DIY14Pflanze/diyPflanze/linuxStation/README.txt

Hier kommt der Code für die Linuxstation (Banapie) rein.
