DIY14Pflanze/diyPflanze/doku/doku2.tex

\documentclass[]{IEEEtran}
\usepackage[utf8]{inputenc}		%UTF8 input file
\usepackage[T1]{fontenc}		
\usepackage[ngerman]{babel}
\usepackage{amsmath, amssymb}
\usepackage{eurosym}
\usepackage{hyperref}
%Für Fußzeilten
%\usepackage{stfloats}
%Bilder
\usepackage{graphicx}
\usepackage{epstopdf}
%Zeilenabstände
\usepackage{setspace}

%Für Quellcode
\usepackage{listings}

\title{Pflanzengießanlage}
%\subtitle{DIY14Pflanze}
\date{\today}
\author{ Stefan Schubäck, \and Matthias Nagl,\and Christoph Hofbauer, \and Dmitrii Cetvericov, \and Markus Fischer-Has,}

%\renewcommand{\iedlistdecl}{\settowidth{\labelwidth}{Hello}}

\begin{document}

	\maketitle
%	\tableofcontents

\begin{abstract}
Auch unter den Studenten gibt es den einen oder anderen mit einem grünen Daumen, der seine Wohnung durch ein paar Pflanzen aufgewertet hat. 
Wenn nicht das ständige Gießen wäre. 
Vor jedem längeren Urlaub stellt sich die Frage, was machen mit den Pflanzen? 
Den Nachbarn fragen und hoffen er ist da und verlässlich? 
Die Pflanzen \glqq absaufen\grqq \ lassen und hoffen, dass sie sich das Wasser einteilen? 
Beides keine zufriedenstellende Lösung. Wieso lässt man die Pflanze sich nicht selbst gießen?
Aus diesen Überlegungen ist die Idee entstanden eine Pflanze mit Sensoren auszustatten und so deren Zustand zu überwachen und über diesen zu informieren.
Im Folgenden wird der Aufbau zweier Lösungen vorgestellt. 

Der erste Ansatz basiert auf dem Arduino"~System, welches einen einfachen Einstieg in Umgang mit Mikrocontroller ermöglicht. 
Der zweite Ansatz basiert auf ähnlicher Hardware, jedoch ohne die Verwendung der Arduino"~Software. 
Dadurch wird die Verwendung von Sleep"~Modi und Interrupts möglich was eine Low"~Energy Variante des Gießsystems ermöglicht.  

\end{abstract}

\section{Eingrenzung}
Es lassen sich viele Faktoren finden, die einen Einfluss auf das Wohlbefinden eine Pflanze haben. 
Hierunter fallen die Bodenfeuchtigkeit im Topf der Pflanze, die durchschnittliche Sonneneinstrahlung, die Luftqualität, der Nährstoffgehalt des Bodens sowie die Temperatur. 
Diese nicht abschließende Aufzählung zeigt, dass eine Eingrenzung der zu untersuchenden Faktoren notwendig ist, um das Projekt in der gegeben Zeit fertigzustellen.
Auch hinsichtlich des Einsatzgebietes gibt eine Vielfalt von unterschiedlichen Möglichkeiten wie z.B. Einpflanzenbetrieb oder Mehrpflanzenbetrieb sowie In"~ oder Outdoor"~Betrieb. 
Im Rahmen des Projekts werden demnach folgende Eingrenzung vorgenommen:

\begin{itemize}
	\item Die Bodenfeuchtigkeit wird abgeleitet aus der Widerstandsänderung einer Messgabel die sich im Erdreich der Pflanze befindet. Die Widerstandsänderung ergibt sich in Abhängigkeit des Wassergehalts bzw. Feuchtigkeitgrades der Erde.
	\item Das System soll für eine alleinstehende Pflanze aufgebaut werden. 
	\item Das Einsatzgebiet wird im Innenraumbereich sein, dadurch fallen Einschränkungen bzgl. der Witterungs"-beständigkeit weg.
	\item Die Stromversorgung wird über ein Netzteil bewerkstelligt. 
	\item Das System soll über eine drahtlose Verbindung einstellbar sein. Diese Einschränkung gilt nur für die \emph{Arduino"~Variante}, da in der \emph{Sparversion} auf Grund energetischer Optimierung auf die Kommunikation verzichtet wird. Hier wird die Einstellung direkt im Code vorgenommen.

\end{itemize}

Weitere Ideen wie z.B. eine autarke, batteriebetriebene Lösung, ein Mehr"~Pflanzenbetrieb oder ein System für den Garten wurden zwar diskutiert, aber wegen dem erhörten Zeitaufwand hinsichtlich weiterer zu lösender Problemstellungen und begrenzten Budgets nicht weiter verfolgt. 
Im folgenden wird die \emph{Arduino"~Variante} ausführlich vorgestellt. 
Die \emph{Sparversion} wird im Anschluss erläutert. Da viele der Funktionen grundsätzlich identisch sind und übernommen werden können, wird darauf verzichtet diese erneut auszuformulieren. 

%section
\input{arduinoVariante.tex}

%section
\input{sparversion.tex}

\input{fazit.tex}

\end{document}
