DIY14Pflanze/diyPflanze/doku/fazit.tex

\section{Weiterentwicklung}

\subsection{Konfigurationstool}
Um die Daten der Gießanlage auslesen und die Konfiguration auf eine Pflanze vornehmen zu können, fehlt noch das PC"~Programm. 
Dieses Programm soll über eine Oberfläche die Einstellungen der Gießanlage(-n) anzeigen und diese auf die jeweilige Pflanze, Boden- und Licht"-Verhältnisse anpassen können.
Es gibt erste Ansätze, die jedoch noch am Anfang ihrer Entwicklung stehen.

\subsection{Kapazitive Bodenfeuchtigkeitsmessung}
Das größte Problem vor dem wir stehen, ist der sich durch Elektrolyse zersetzende Bodenfeuchtigkeitssensor.
Durch das seltenere Messen und das Umpolen lässt sich die Lebensdauer des Sensor deutlich verlängern, aber die Selbstzerstörung nicht aufhalten.
So nimmt die Leitfähigkeit des Sensors mit der Zeit ab und die Messwerte verringern sich über die Zeit.
Außerdem besteht der Sensor aus einer verzinkten Kupferplatine und durch die Korrosion werden Kupferionen frei gesetzt. 
Diese werden von den Pflanzen aufgenommen. Falls es sich um Nutzpflanzen zum Verzehr handelt, gelangen die giftigen Kupferionen in den menschlichen Körper.
Deswegen wurde hier vorgeschlagen einen kapazitiven Sensor zu verwenden. 
Bei einem kapazitiven Sensor berührt kein Metall die Pflanzenerde, so kommt es zu keiner Korrosion.
Dafür muss eine Kapazität gemessen werden, was schaltungstechnisch schwer zu realisieren ist\footnote{\href{http://www.dl8nci.de/lc-meter-001.html}{http://www.dl8nci.de/lc-meter-001.html}}.
