DIY14Pflanze/diyPflanze/gehaeuse/box-20150116_081555_312084.pdf

Cut Width: 0.0000mm
Material Thickness: 3.0000mm
W x D x H: 95.00mm x 65.00mm x 50.00mm
Produced by BoxMaker v2.0.1 on 01/16/2015 at 08:15:55 http://boxmaker.connectionlab.org
