DIY14Pflanze/diyPflanze/microcontroller/src/README.txt

Hier kommt der Code für den Mikrocontroller rein.
