DIY14Pflanze/diyPflanze/doku/bilder/boxFron0.JPG

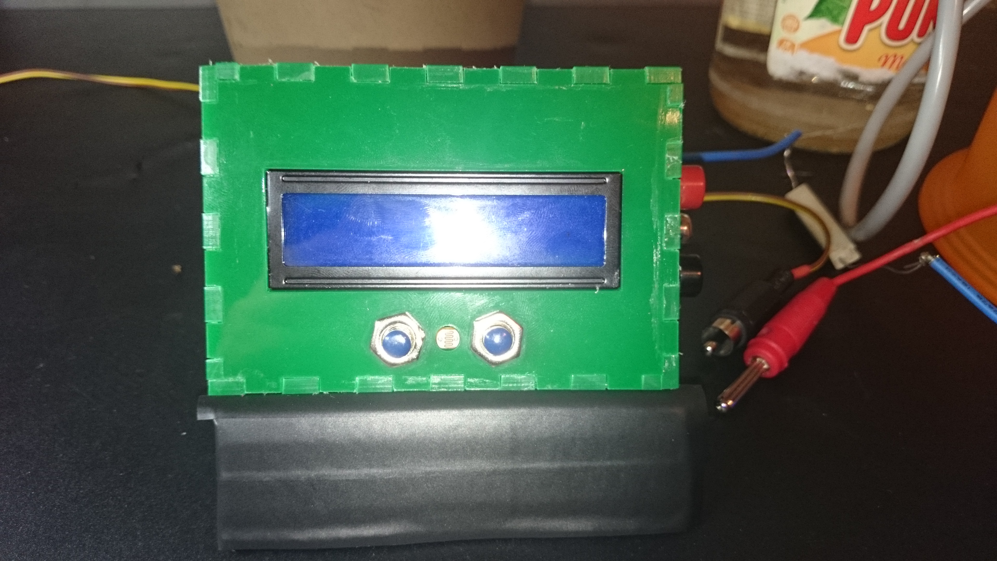
doku/bilder/boxFron0.JPG
