DIY14Pflanze/diyPflanze/doku/bilder/boxFron1.JPG

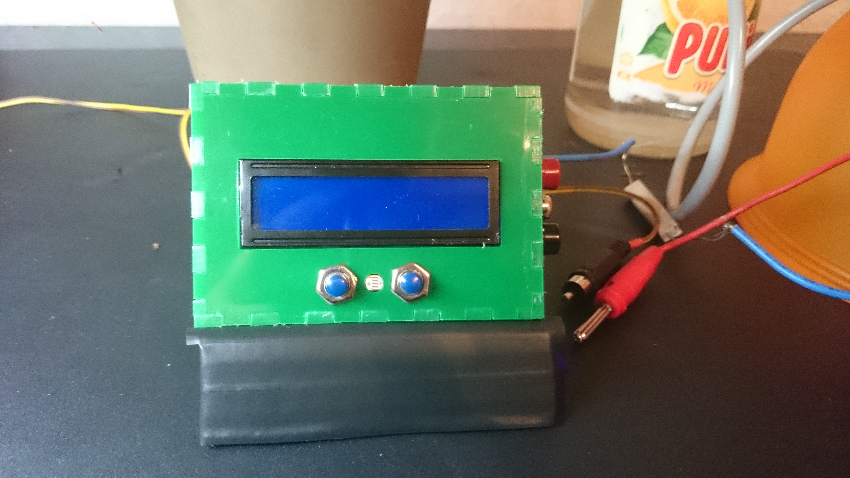
doku/bilder/boxFron1.JPG
