DIY14Pflanze/diyPflanze/doku/bilder/boxInnen0.JPG

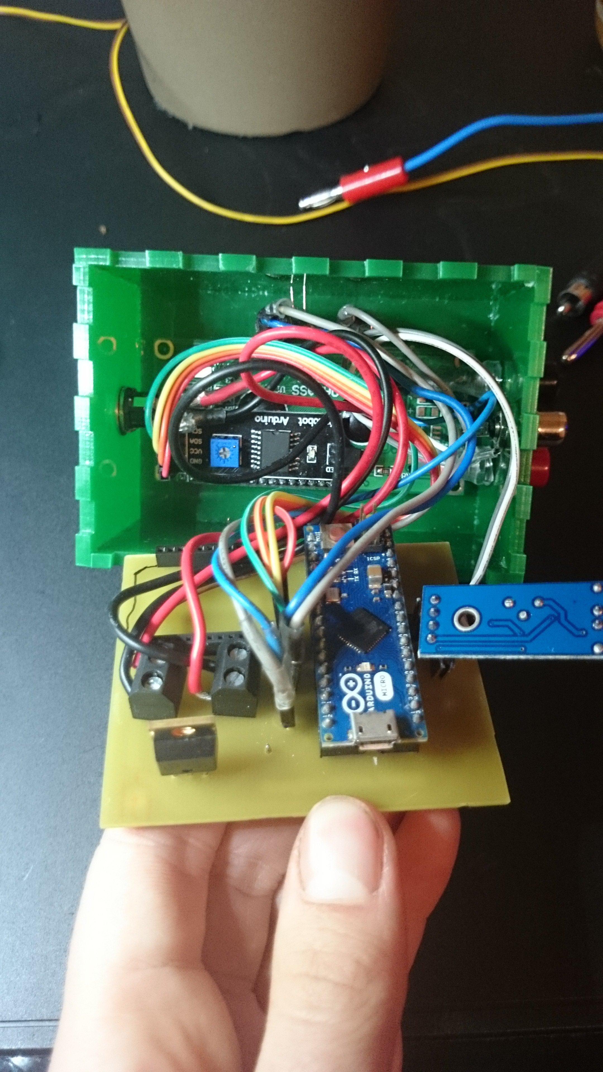
doku/bilder/boxInnen0.JPG
