DIY14Pflanze/diyPflanze/doku/bilder/boxPeripherie0.JPG

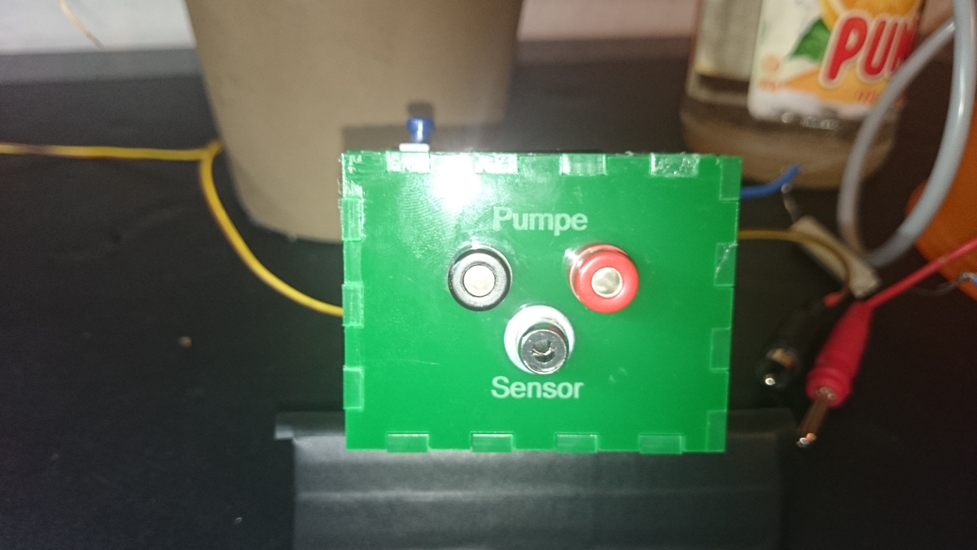
doku/bilder/boxPeripherie0.JPG
