DIY14Pflanze/diyPflanze/doku/bilder/boxPeripherie1.JPG

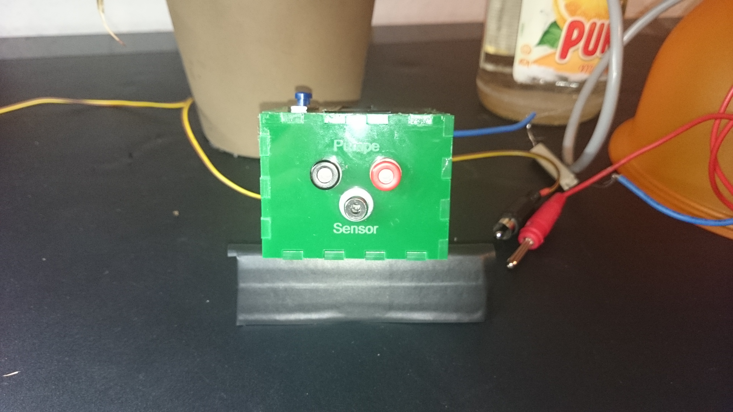
doku/bilder/boxPeripherie1.JPG
