DIY14Pflanze/diyPflanze/doku/bilder/boxStrom0.JPG

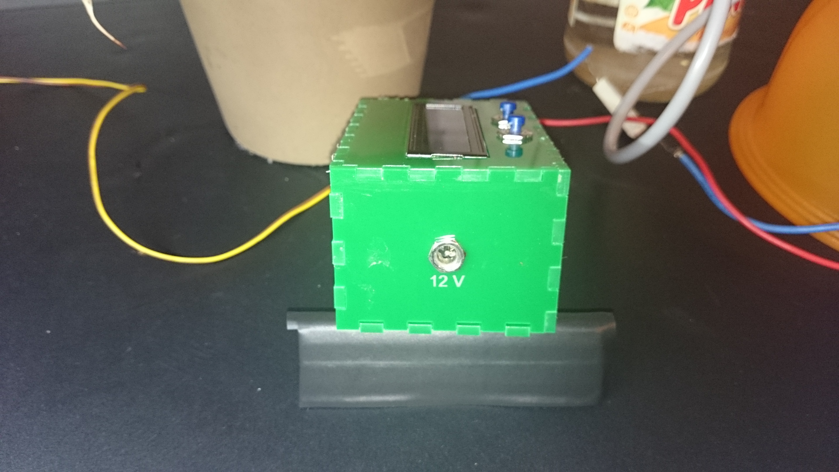
doku/bilder/boxStrom0.JPG
