DIY14Pflanze/diyPflanze/doku/bilder/fechtesensorVergleich0.JPG

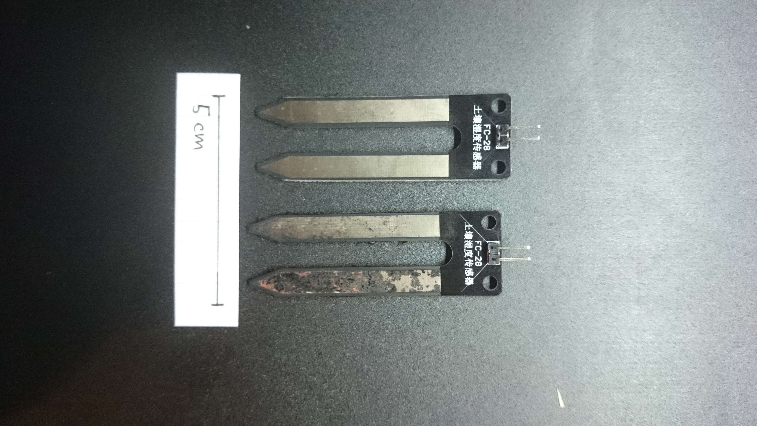
doku/bilder/fechtesensorVergleich0.JPG
