DIY14Pflanze/diyPflanze/doku/bilder/feuchteSensor0.JPG

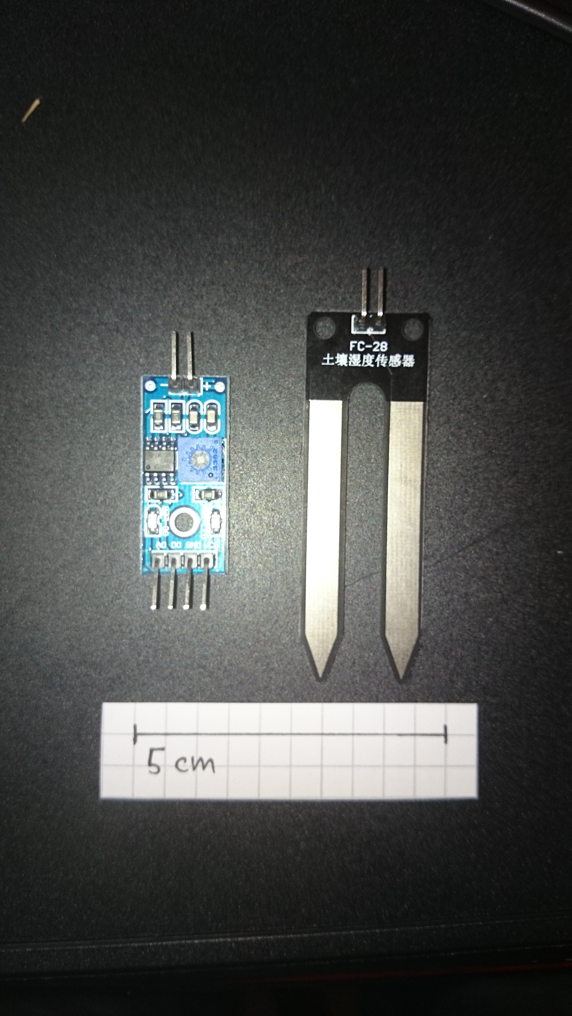
doku/bilder/feuchteSensor0.JPG
