DIY14Pflanze/diyPflanze/doku/bilder/feuchteSensor1.JPG

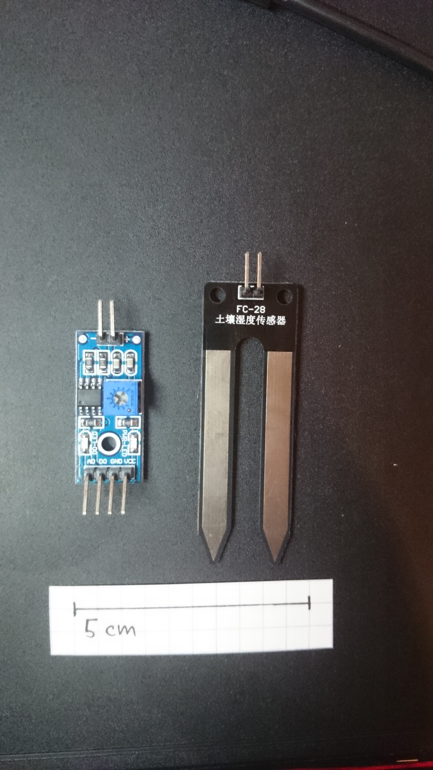
doku/bilder/feuchteSensor1.JPG
