DIY14Pflanze/diyPflanze/doku/bilder/feuchtesensorVergleich1.JPG

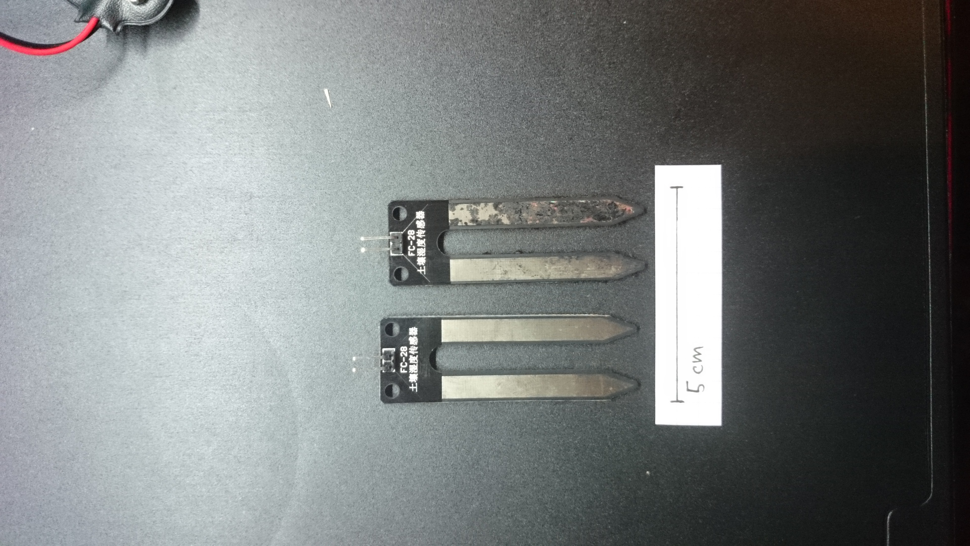
doku/bilder/feuchtesensorVergleich1.JPG
