DIY14Pflanze/diyPflanze/doku/bilder/feuchtesensorVergleich3.JPG

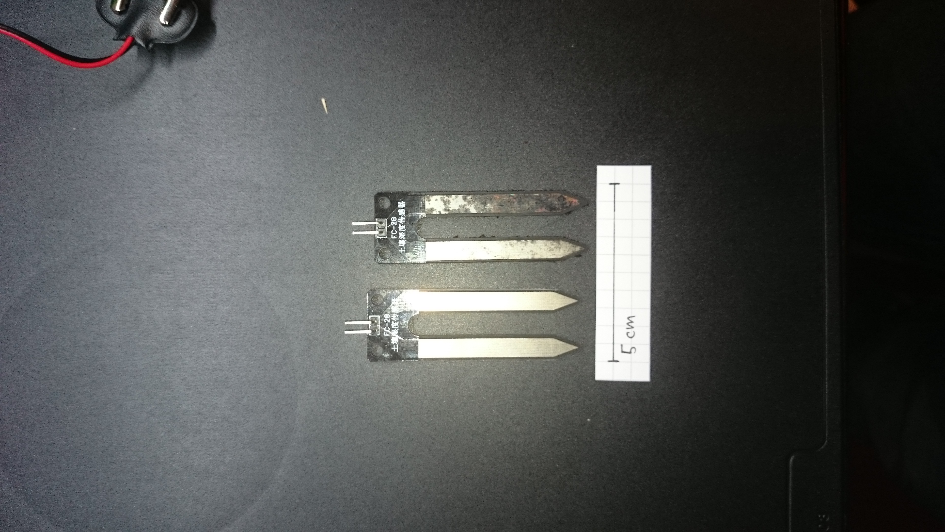
doku/bilder/feuchtesensorVergleich3.JPG
