DIY14Pflanze/diyPflanze/doku/bilder/komplett0.JPG

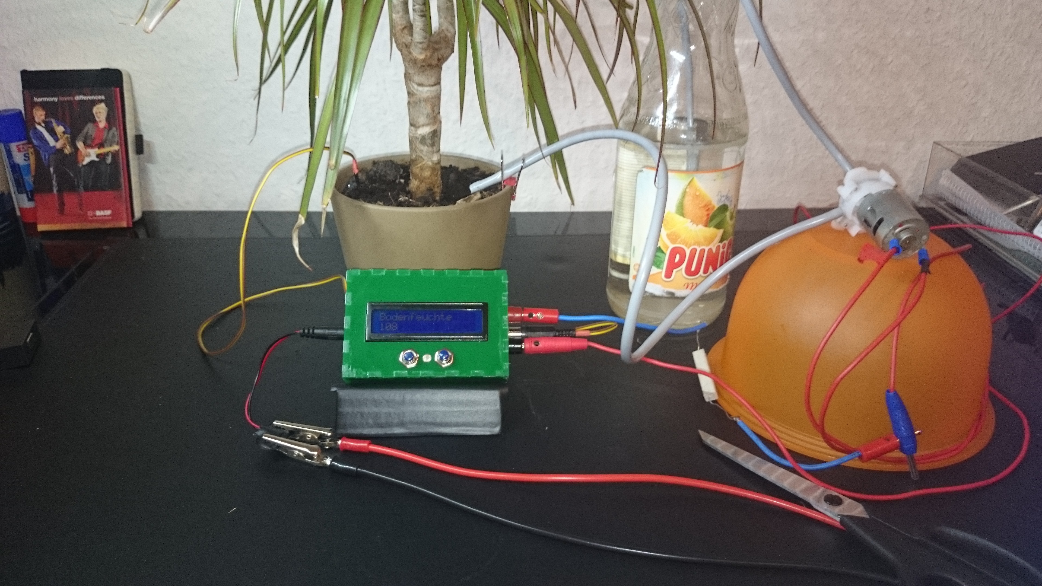
doku/bilder/komplett0.JPG
