DIY14Pflanze/diyPflanze/doku/bilder/komplett0_v1.JPG

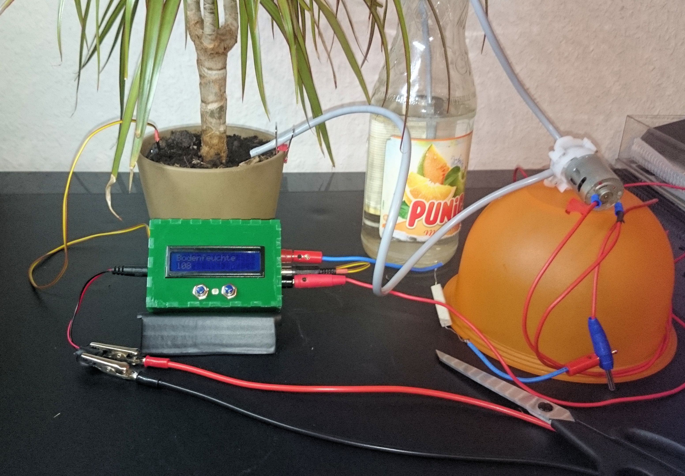
doku/bilder/komplett0_v1.JPG
