DIY14Pflanze/diyPflanze/doku/bilder/komplett1.JPG

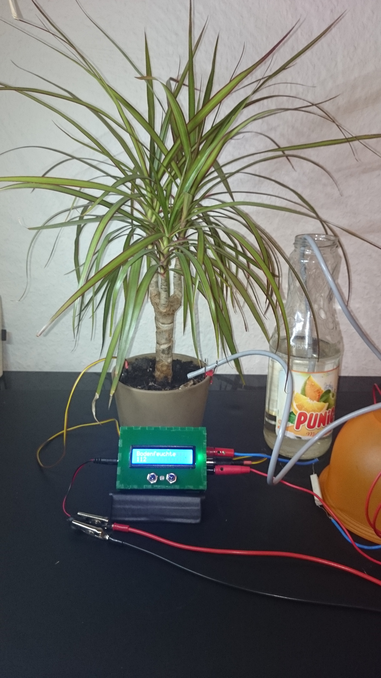
doku/bilder/komplett1.JPG
