DIY14Pflanze/diyPflanze/doku/bilder/Nano+Xbee.png

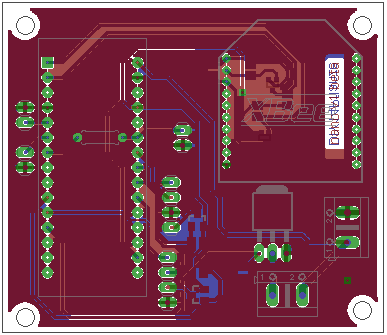
doku/bilder/Nano+Xbee.png
