DIY14Pflanze/diyPflanze/doku/bilder/platineUnten0.JPG

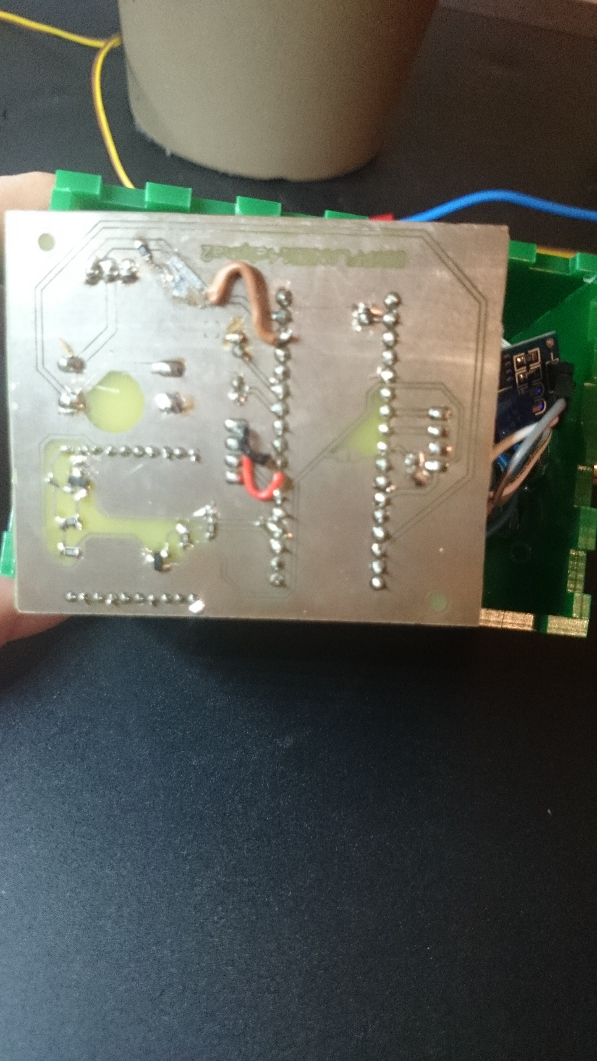
doku/bilder/platineUnten0.JPG
