DIY14Pflanze/diyPflanze/doku/bilder/platineUnten1.JPG

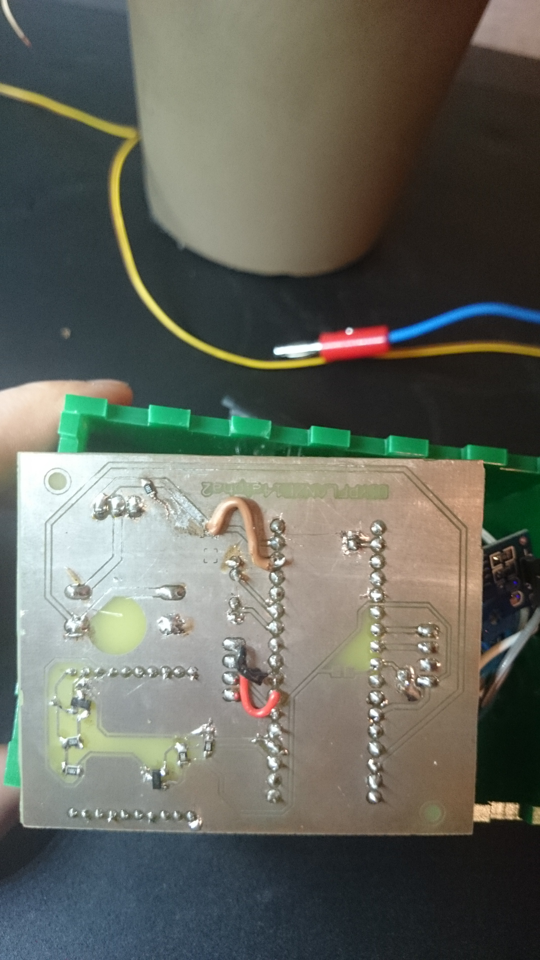
doku/bilder/platineUnten1.JPG
