DIY14Pflanze/diyPflanze/doku/bilder/Sparversion Layout.png

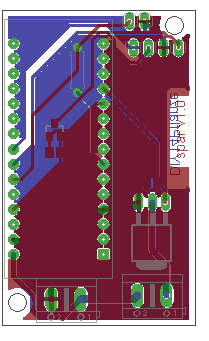
doku/bilder/Sparversion Layout.png
