DIY14Pflanze/diyPflanze/doku/bilder/v1Board.JPG

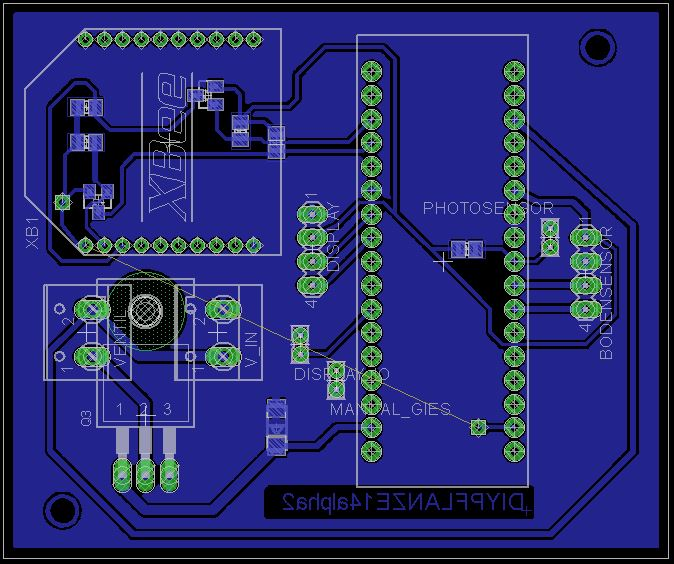
doku/bilder/v1Board.JPG
