DIY14Pflanze/diyPflanze/doku/bilder/v1SchaltplanMicro.JPG

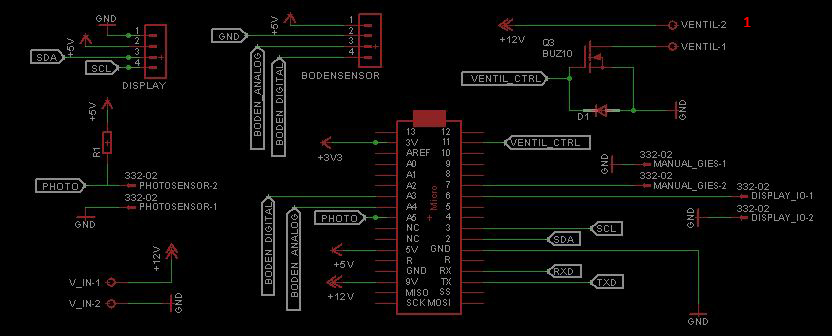
doku/bilder/v1SchaltplanMicro.JPG
