DIY14Pflanze/diyPflanze/doku/Diagramme/AV_Ablaufdiagramm2.png

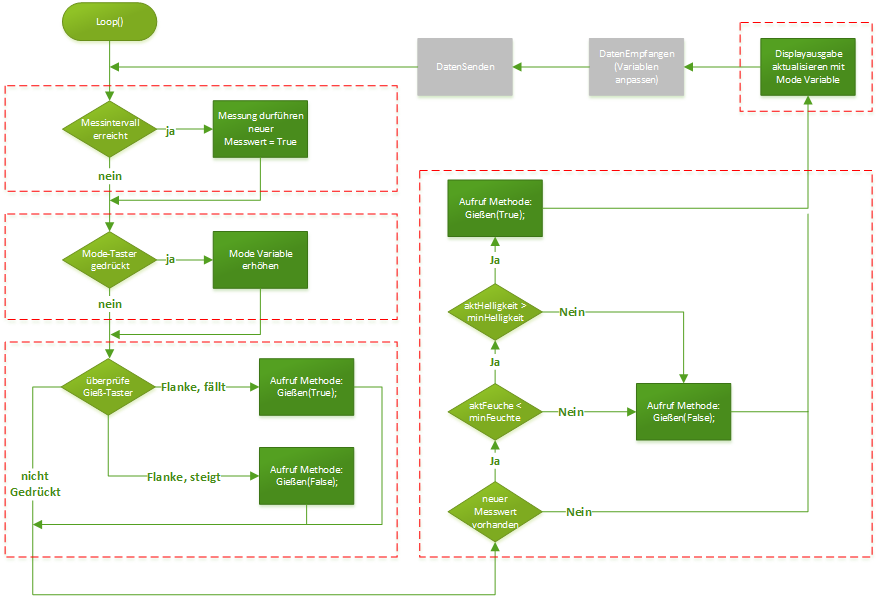
doku/Diagramme/AV_Ablaufdiagramm2.png
