DIY14Pflanze/diyPflanze/doku/Diagramme/AV_Ablaufdiagramm.jpg

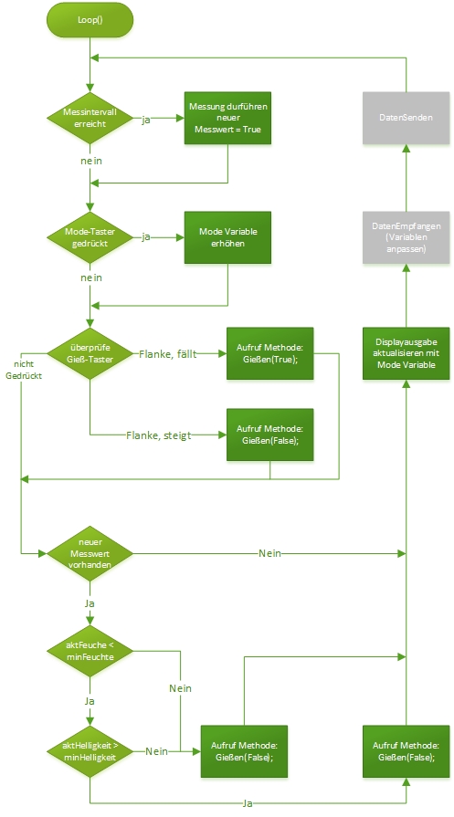
doku/Diagramme/AV_Ablaufdiagramm.jpg
