DIY14Pflanze/diyPflanze/doku/build/README.txt

Dieser Ordner ist für unsere Doku gedacht, die wir in Latex abgeben müssen. Es müssen 6 Seiten sein.
