DIY14Pflanze/diyPflanze/doku/bilder/Bild_Aufbau-eps-converted-to.pdf

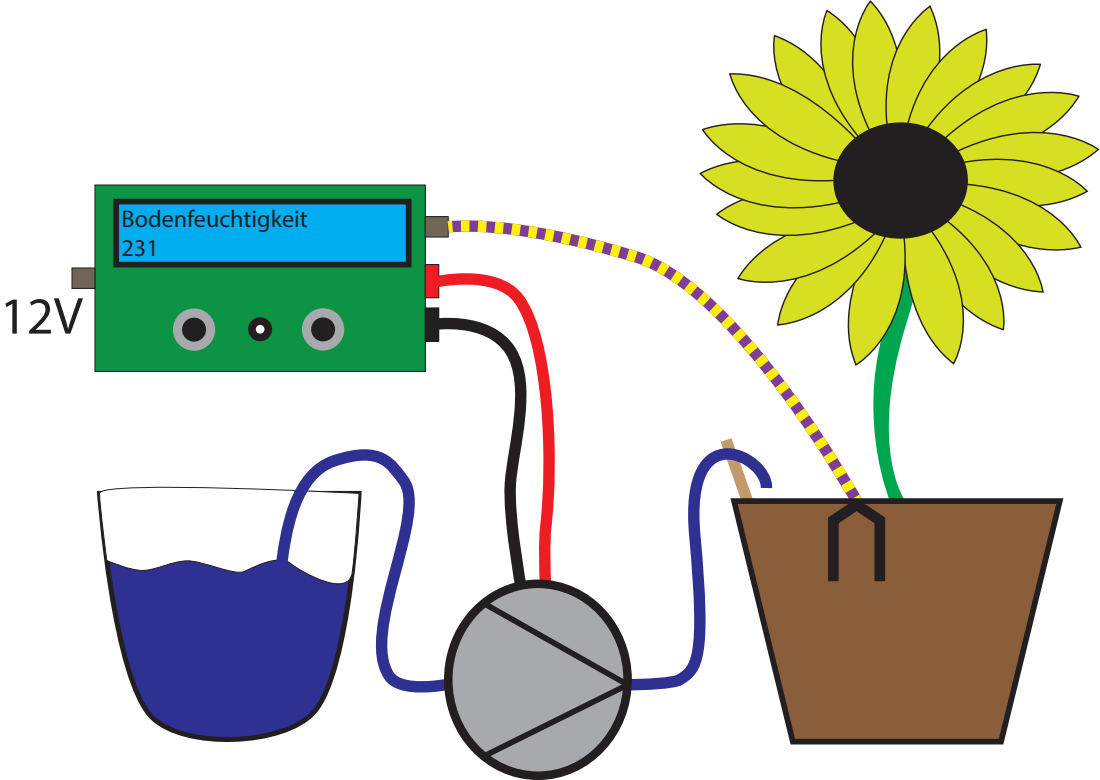
[picture p30: page 1]
Bodenfeuchtigkeit 231
