DIY14Pflanze/diyPflanze/doku/Diagramme/AV_Ablaufdiagramm.pdf

ja

### nein

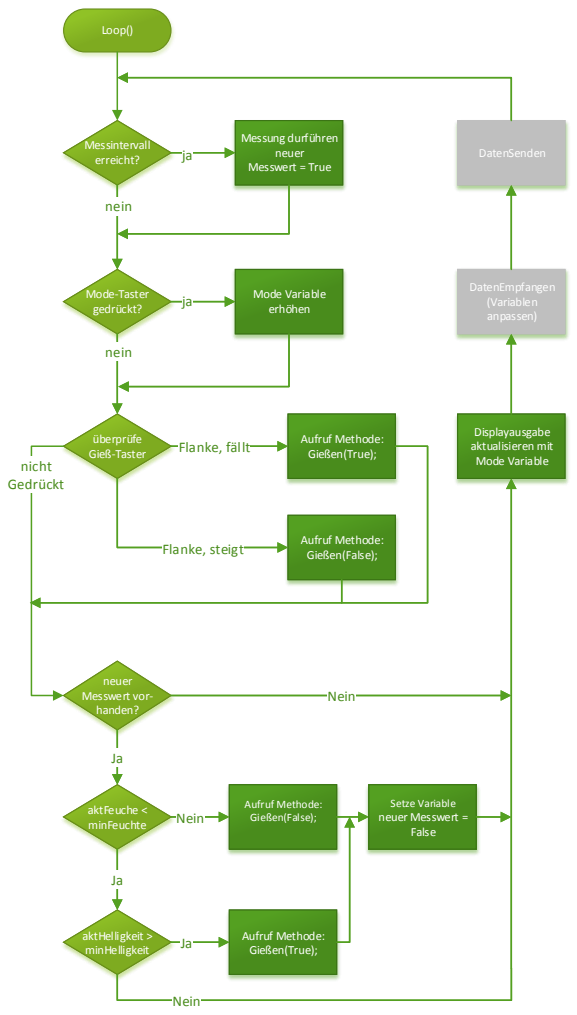
[picture p31: page 1]
Loop(); Messintervall erreicht?; Mode Variable erhöhen; Mode-Taster gedrückt?; Messung durführen neuer Messwert = True; neuer Messwert vor- handen?; Aufruf Methode: Gießen(True);; Aufruf Methode: Gießen(False);; überprüfe Gieß-Taster; Displayausgabe aktualisieren mit Mode Variable; DatenEmpfangen (Variablen anpassen); aktFeuche < minFeuchte; aktHelligkeit > minHelligkeit; nein; Flanke, steigt; Flanke, fällt; DatenSenden; Nein; Setze Variable neuer Messwert = False; nicht Gedrückt
