DIY14Pflanze/diyPflanze/eagle/arduinoMicro_v1_0/Nano_gies.pdf

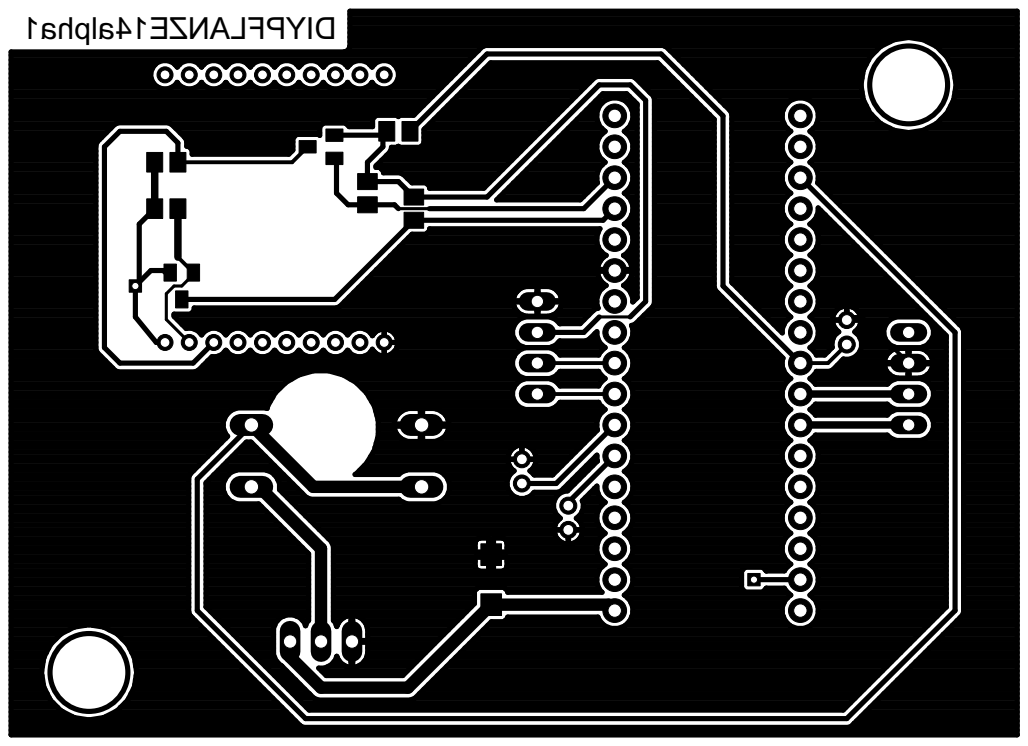
[picture p32: page 1]
