DIY14Pflanze/diyPflanze/eagle/arduinoMicro_v1_0/Nano_gies2.pdf

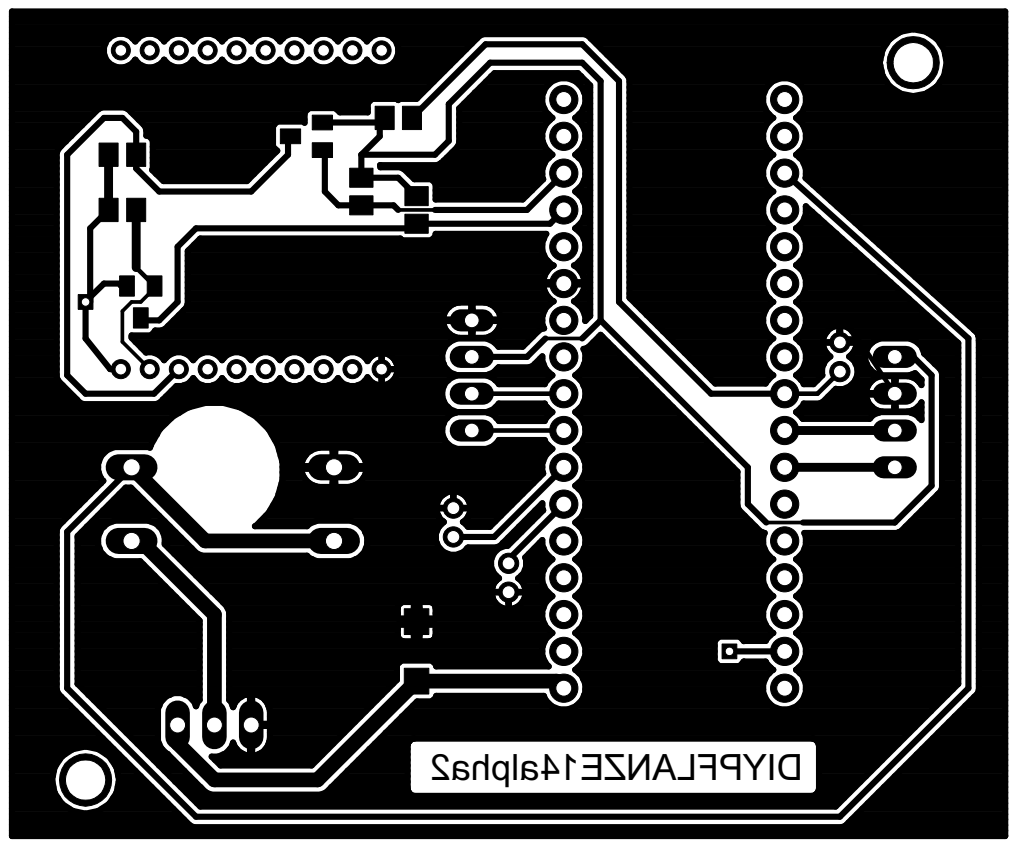
[picture p33: page 1]
