DIY14Pflanze/diyPflanze/eagle/arduinoMicro_v1_0/Nano_gies3.pdf

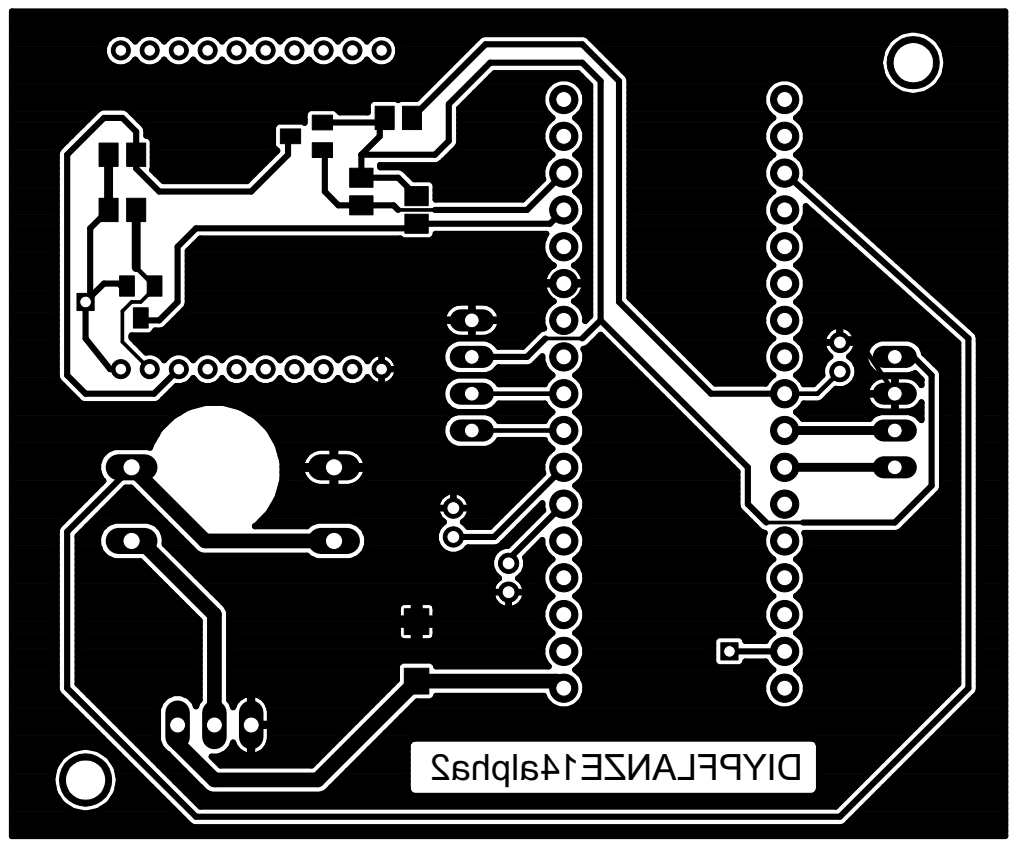
[picture p34: page 1]
