DIY14Pflanze/diyPflanze/eagle/arduinoMicro_v1_0/Nano_gies4.pdf

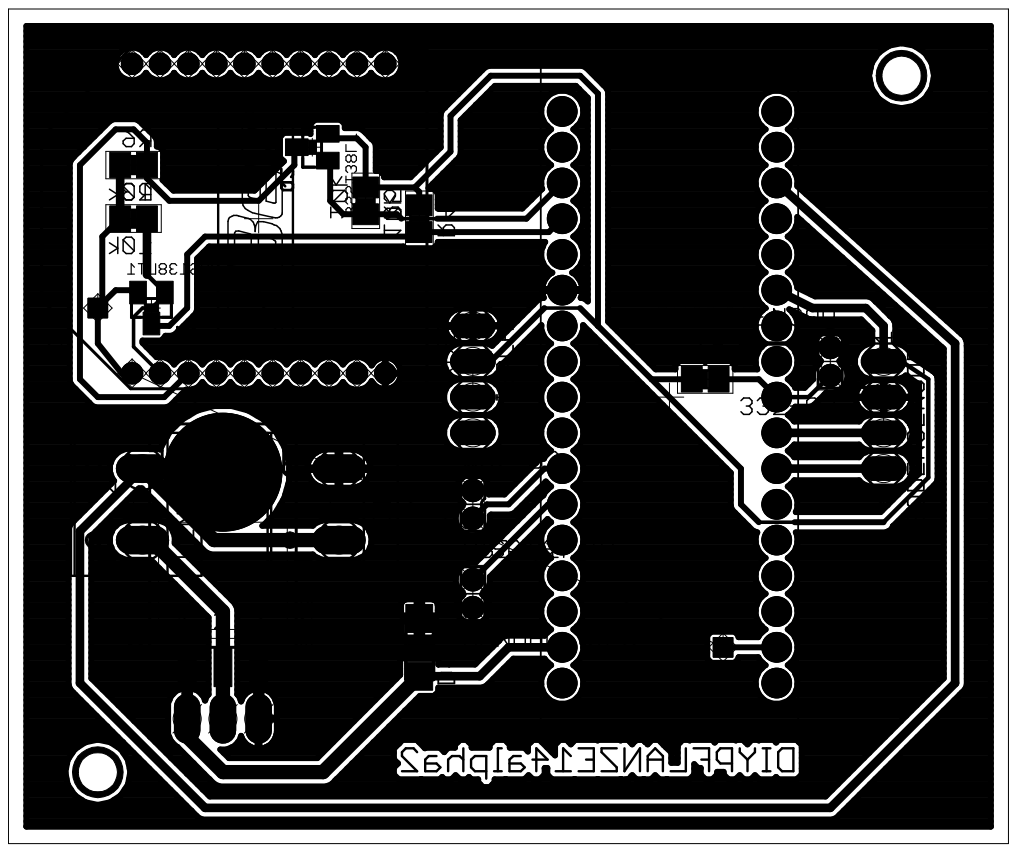
[picture p35: page 1]
