DIY14Pflanze/diyPflanze/eagle/arduinoMicro_v1_0/Nano_gies5.pdf

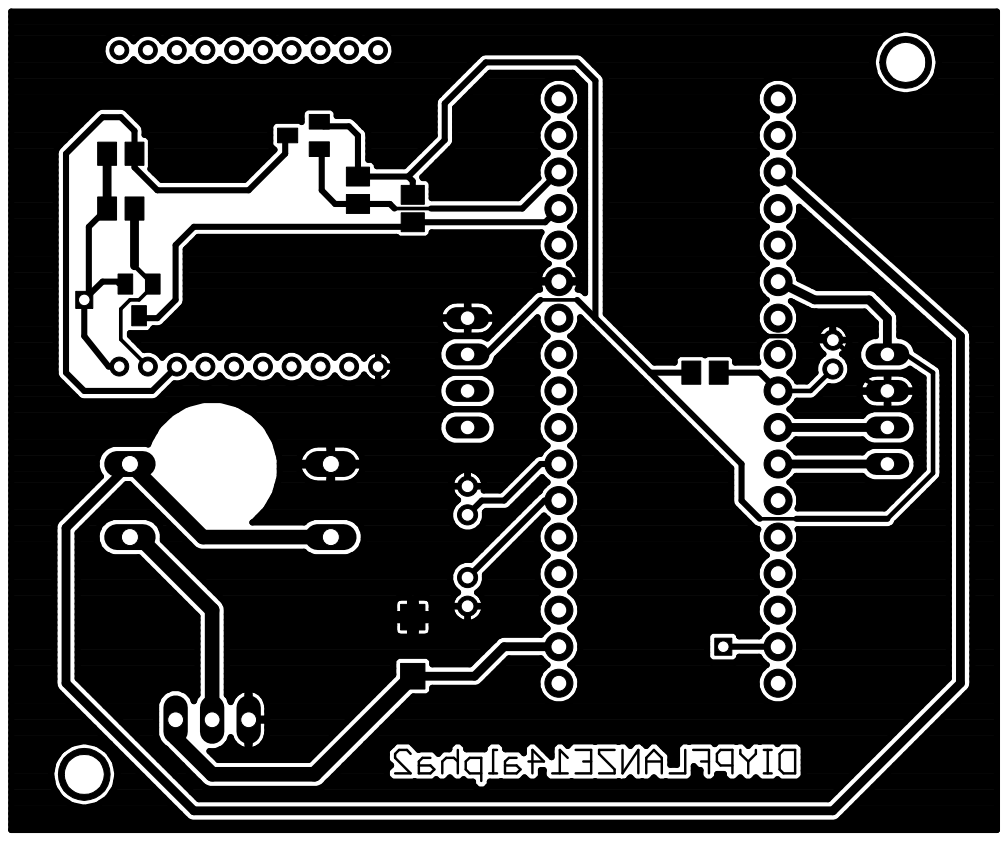
[picture p36: page 1]
