DIY14Pflanze/diyPflanze/eagle/Arduino Nano/Sparversion/Nano XBee.brd

## EAGLE design eagle/Arduino Nano/Sparversion/Nano XBee.brd (2015-02-25)

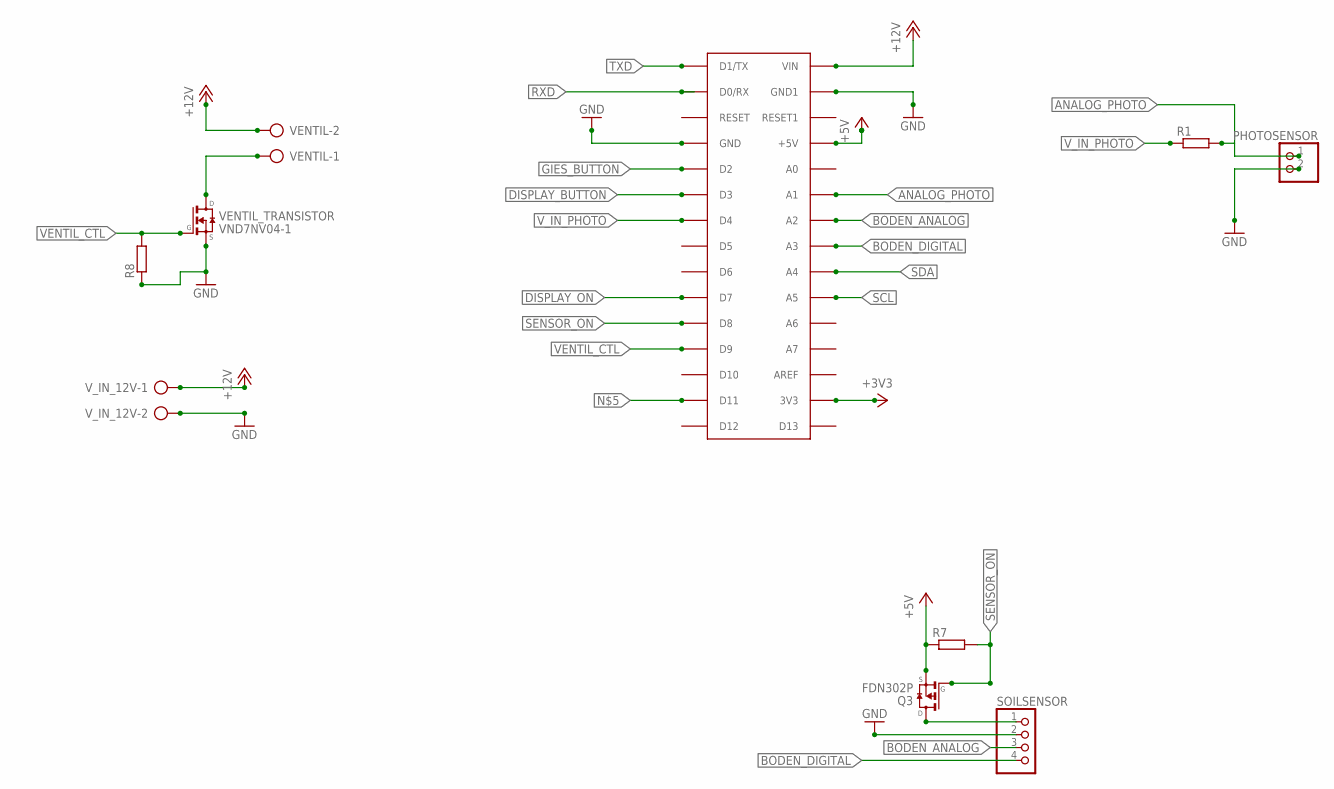
[picture p37: schematic Nano XBee.sch]

Parts:
PHOTOSENSOR: PINHD-1X2; 1X02
Q3: FDN302P; SSOT-3
R1: R-EU_0207/7; 0207/7
R7, R8: R-EU_M0805; M0805
SOILSENSOR: PINHD-1X4; 1X04
U$1: ARDUINONANO; PDIP-32
VENTIL: AK500/2
VENTIL_TRANSISTOR: VND7NV04-1; IPAK
V_IN_12V: AK500/2

Connections:
+3V3: U$1.3V3
+5V: Q3.2 (S), R7.1, U$1.+5V
+12V: U$1.VIN, VENTIL.2, V_IN_12V.1
ANALOG_PHOTO: PHOTOSENSOR.1, R1.2, U$1.A1
BODEN_ANALOG: SOILSENSOR.3, U$1.A2
BODEN_DIGITAL: SOILSENSOR.4, U$1.A3
DISPLAY_BUTTON: U$1.D3
DISPLAY_ON: U$1.D7
GIES_BUTTON: U$1.D2
GND: PHOTOSENSOR.2, R8.1, SOILSENSOR.2, U$1.GND, U$1.GND1, VENTIL_TRANSISTOR.3 (S), V_IN_12V.2
unnamed: VENTIL.1, VENTIL_TRANSISTOR.2 (D)
unnamed: Q3.3 (D), SOILSENSOR.1
RXD: U$1.D0/RX
SCL: U$1.A5
SDA: U$1.A4
SENSOR_ON: Q3.1 (G), R7.2, U$1.D8
TXD: U$1.D1/TX
VENTIL_CTL: R8.2, U$1.D9, VENTIL_TRANSISTOR.1 (G)
V_IN_PHOTO: R1.1, U$1.D4

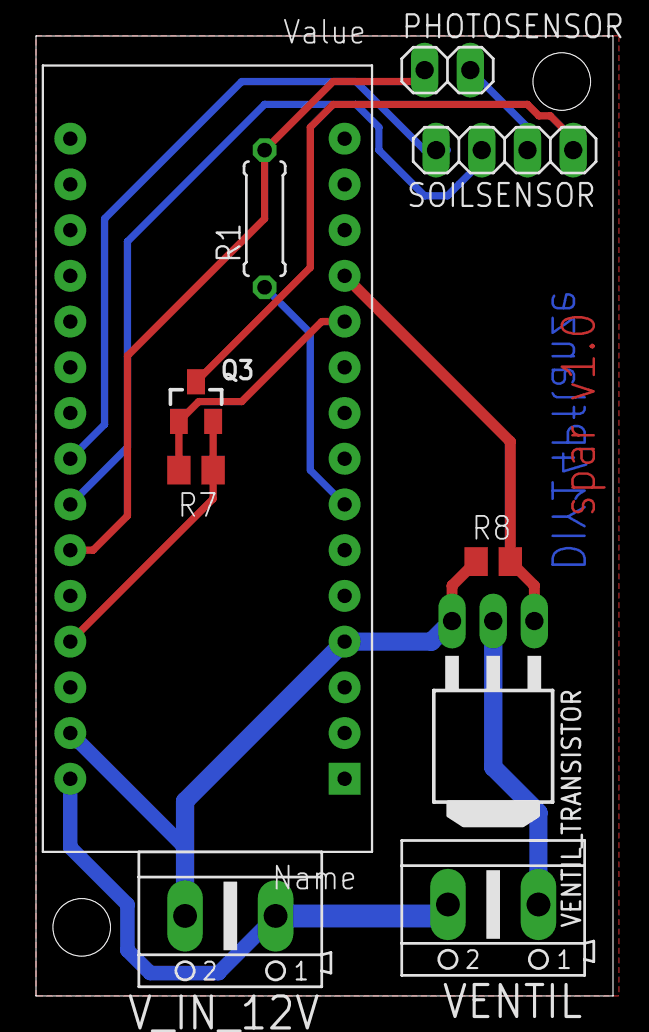
[picture p38: board Nano XBee.brd from above]

Board: 2 copper layers, 32.1 x 53.3 mm, 10 parts (0 on the bottom side), 11 nets.
