DIY14Pflanze/diyPflanze/eagle/arduinoMicro_v1_0/Nano_gies.brd

## EAGLE design eagle/arduinoMicro_v1_0/Nano_gies.brd (2015-02-22)

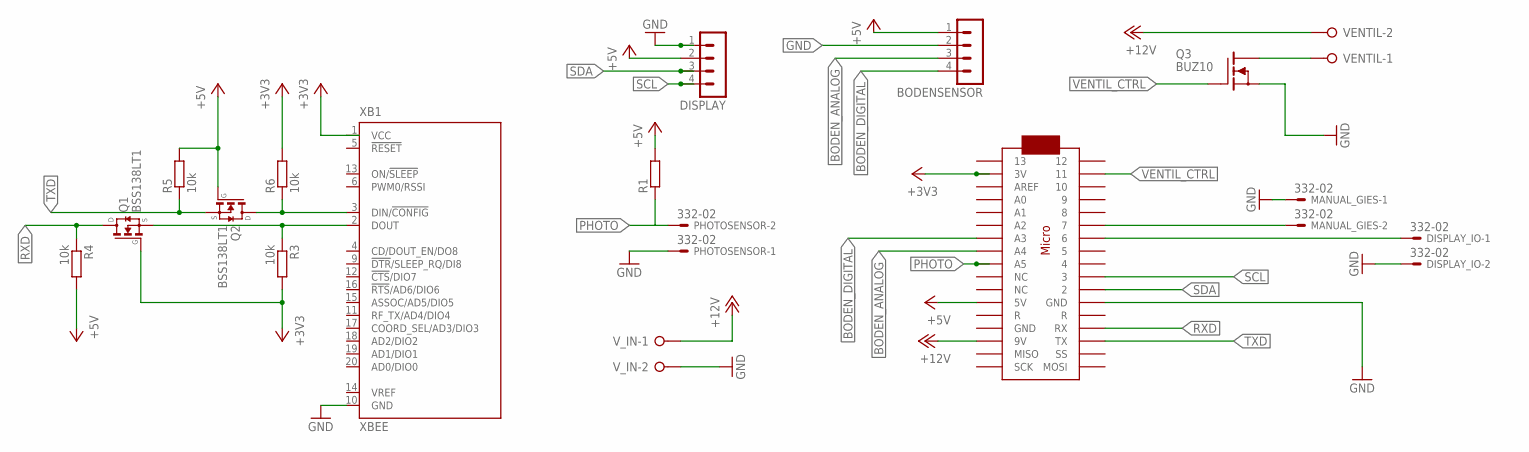
[picture p39: schematic Nano_gies.sch]

Parts:
BODENSENSOR: MA04-1
DISPLAY: MA04-1
DISPLAY_IO: 332-02
MANUAL_GIES: 332-02
PHOTOSENSOR: 332-02
Q1, Q2: BSS138LT1; SOT23
Q3: BUZ10; TO220
R1: R-EU_M0805; M0805
R3, R4, R5, R6: 10k; M0805
U$1: ARDUINOMICRO
VENTIL: W237-02P; W237-132
V_IN: W237-02P; W237-132
XB1: XBEE

Connections:
+3V3: Q1.1 (G), R3.2, R6.2, U$1.P$33 (3V), XB1.1 (VCC)
+5V: BODENSENSOR.1, DISPLAY.2, Q2.1 (G), R1.2, R4.2, R5.2, U$1.P$23 (5V)
+12V: U$1.P$20 (9V), VENTIL.2, V_IN.1
BODEN_ANALOG: BODENSENSOR.3, U$1.P$27 (A4)
BODEN_DIGITAL: BODENSENSOR.4, U$1.P$28 (A3)
GND: BODENSENSOR.2, DISPLAY.1, DISPLAY_IO.2, MANUAL_GIES.1, PHOTOSENSOR.1, Q3.3 (S), U$1.P$21 (GND), V_IN.2, XB1.10 (GND)
unnamed: MANUAL_GIES.2, U$1.P$6 (7)
unnamed: Q1.2 (S), R3.1, XB1.2 (DOUT)
unnamed: DISPLAY_IO.1, U$1.P$7 (6)
unnamed: Q3.2 (D), VENTIL.1
unnamed: Q2.3 (D), R6.1, XB1.3 (DIN/!CONFIG)
PHOTO: PHOTOSENSOR.2, R1.1, U$1.P$26 (A5)
RXD: Q1.3 (D), R4.1, U$1.P$14 (RX)
SCL: DISPLAY.4, U$1.P$10 (3)
SDA: DISPLAY.3, U$1.P$11 (2)
TXD: Q2.2 (S), R5.1, U$1.P$15 (TX)
VENTIL_CTRL: Q3.1 (G), U$1.P$2 (11)

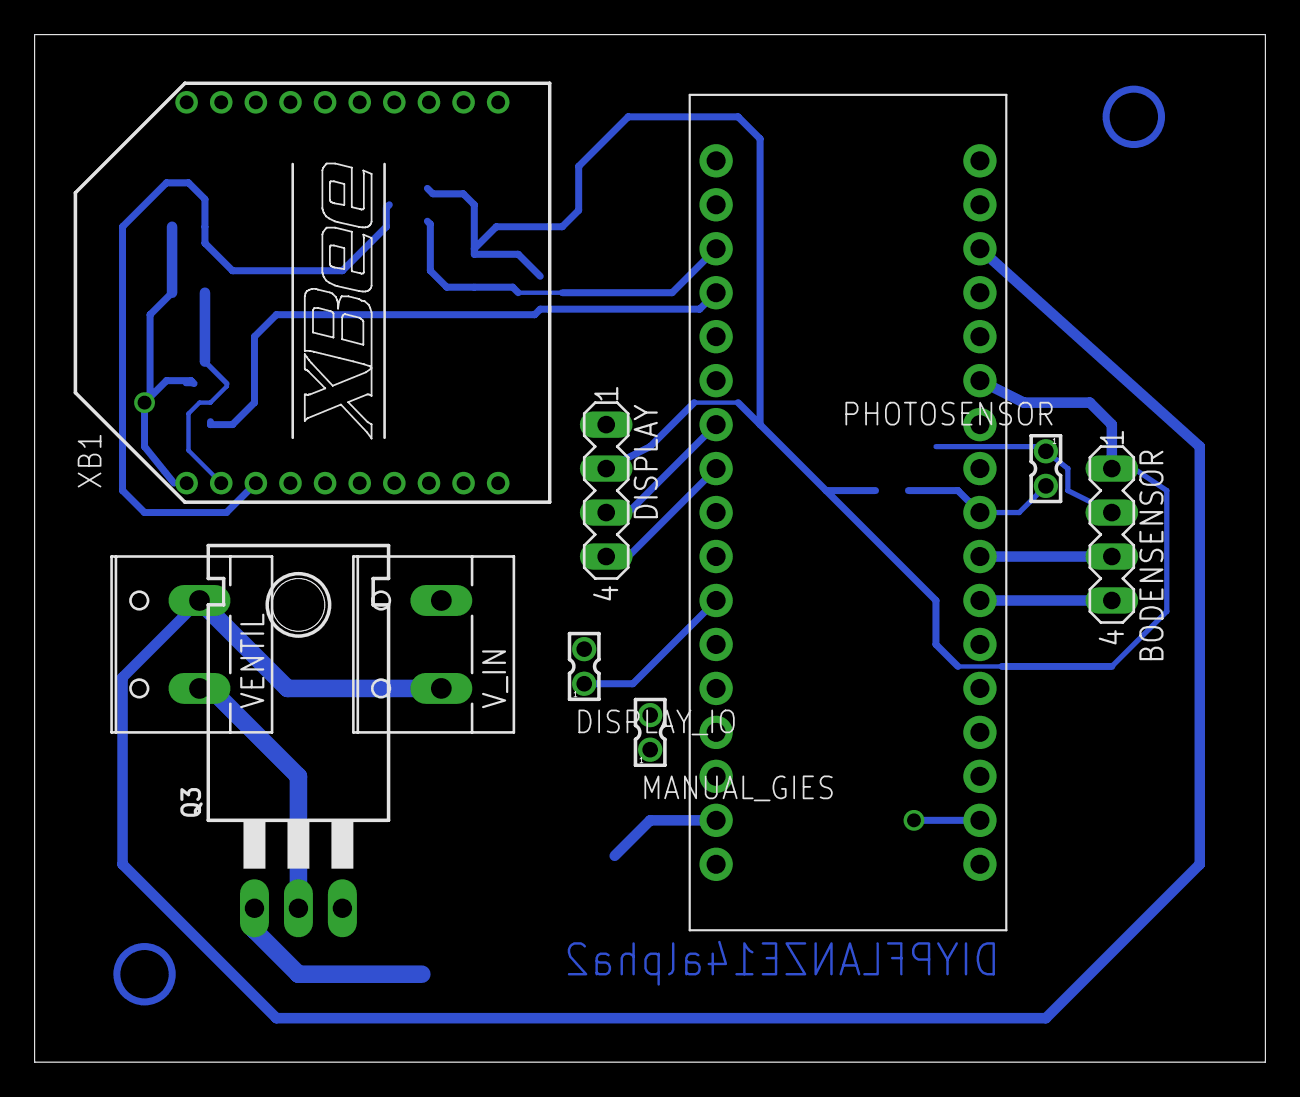
[picture p40: board Nano_gies.brd from above]

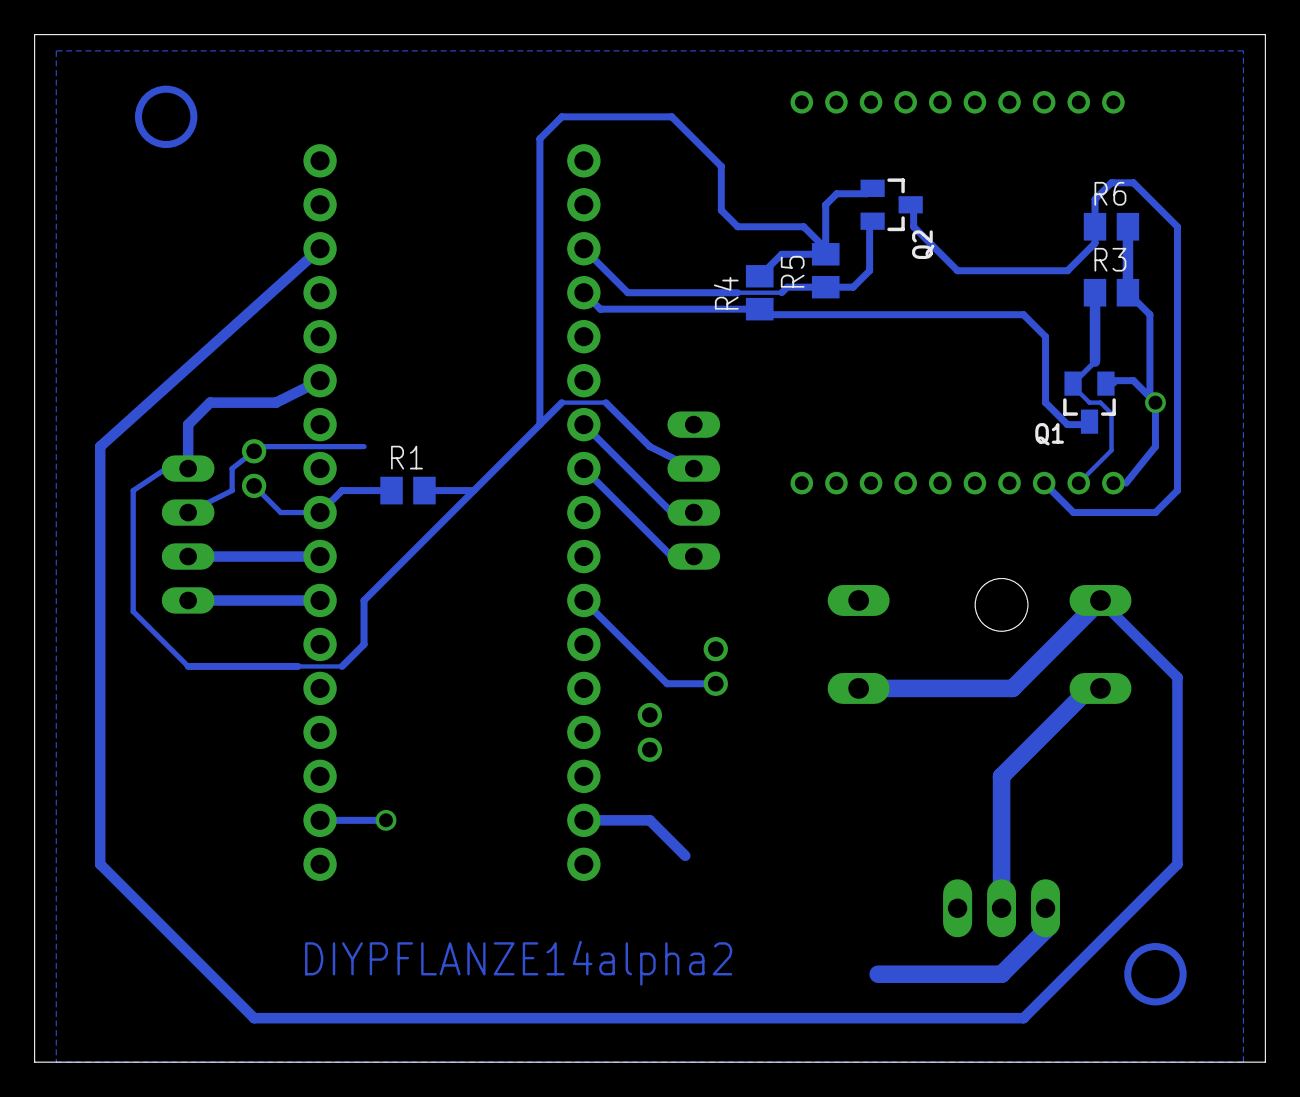
[picture p41: board Nano_gies.brd from below]

Board: 2 copper layers, 71.1 x 59.4 mm, 17 parts (7 on the bottom side), 17 nets.
