DIY14Pflanze/diyPflanze/(commit log)

2015-01-29 Erste Version vom arduino Programm
2015-02-10 Add: Schaltplan fuer den Arduino Nano mit XBee //Es fehlt noch das Layout
    [Nano XBee.sch]
2015-02-11 add: Layout fuer Nano+XBee modified: kleine Aenderung am Schaltplan
    [Nano XBee.brd]
2015-02-15 Code fuer Taster erstellt und so umgeschrieben, dass die einstellungen remot geaendert werden koennen.
2015-02-20 Gehaeuse Plan und Software von Dmitrii
2015-02-20 Version 1.0 der Hauptplatine
    [Nano_gies.brd, Nano_gies.sch]
2015-02-21 Anpassung eagel Files für Grafiken für die Doku. Bilder in Doku eingefügt
    [Nano_gies.brd, Nano_gies.sch]
2015-02-22 anpassung der Fehler im Schaltplan beim Anschluss XBee zum Mikrocontroller
    [Nano_gies.brd, Nano_gies.sch]
2015-02-24 Erweiterung der Dokumentation -Fehlerbeseitigung +Ausweitung des Textes
2015-02-24 Erweiterung der Dokumentation +Sparversion erweitert
2015-02-25 Eagle Sparversion (Layout+Schaltplan) +Schaltplan Sparversion +Layout Sparversion Doku: Sparversion erweitert
    [Nano XBee.brd, Nano XBee.sch]
2015-02-25 Programm fuer die Sparversion +Einfaches Programm fuer die Sparversion
2015-02-25 Erste Korrektur der Doku. Einfügen von Erklärung Pegelwandler
2015-02-25 Sparversion Kalibrierung der Sensors eingefügt
2015-02-25 Ablaufgrafik für Arduinocode erstellt und in doku eingefügt
2015-02-25 Kapitel Programm für Arduino Version ausformuliert. Neues Packet eingefügt für Code-Teile
2015-02-25 Sechs Seiten Dokumentation: fazit.tex: Weiterentwicklung hinzugefügt arduinoVariante.tex: Schaltplan verschoben Bilder (SV_Ablaufplan, Schaltplan) etwas verkleinert Warnings reduziert
2015-02-26 Fehlerverbesserung der Doku
2015-02-26 Doku: Noch mehr Kommas gesetzt und Rechtschreibung
